tapir/RemoteBOY/README.md

Mechanical Files: https://cad.onshape.com/documents/e0ada551acd8132e7ef75c1d/w/a94723651199e5762ecd29c6/e/211c17ef0ce3b004e12369c1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
