tapir/RemoteBOY/KiCAD/Keystone_1020/1020.step

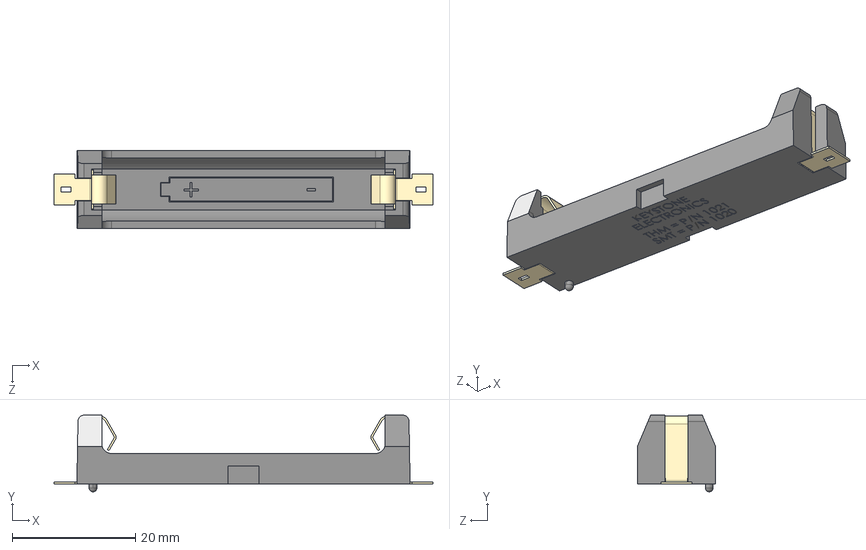
[picture p1: CAD file, 2024-03-24]
KiCAD/Keystone_1020/1020.step
61.5 x 12.4 x 12.7 mm
