tapir/RemoteBOY/KiCAD/remoteboy.kicad_pcb

## KiCad design KiCAD/remoteboy.kicad_pcb (2024-04-02)

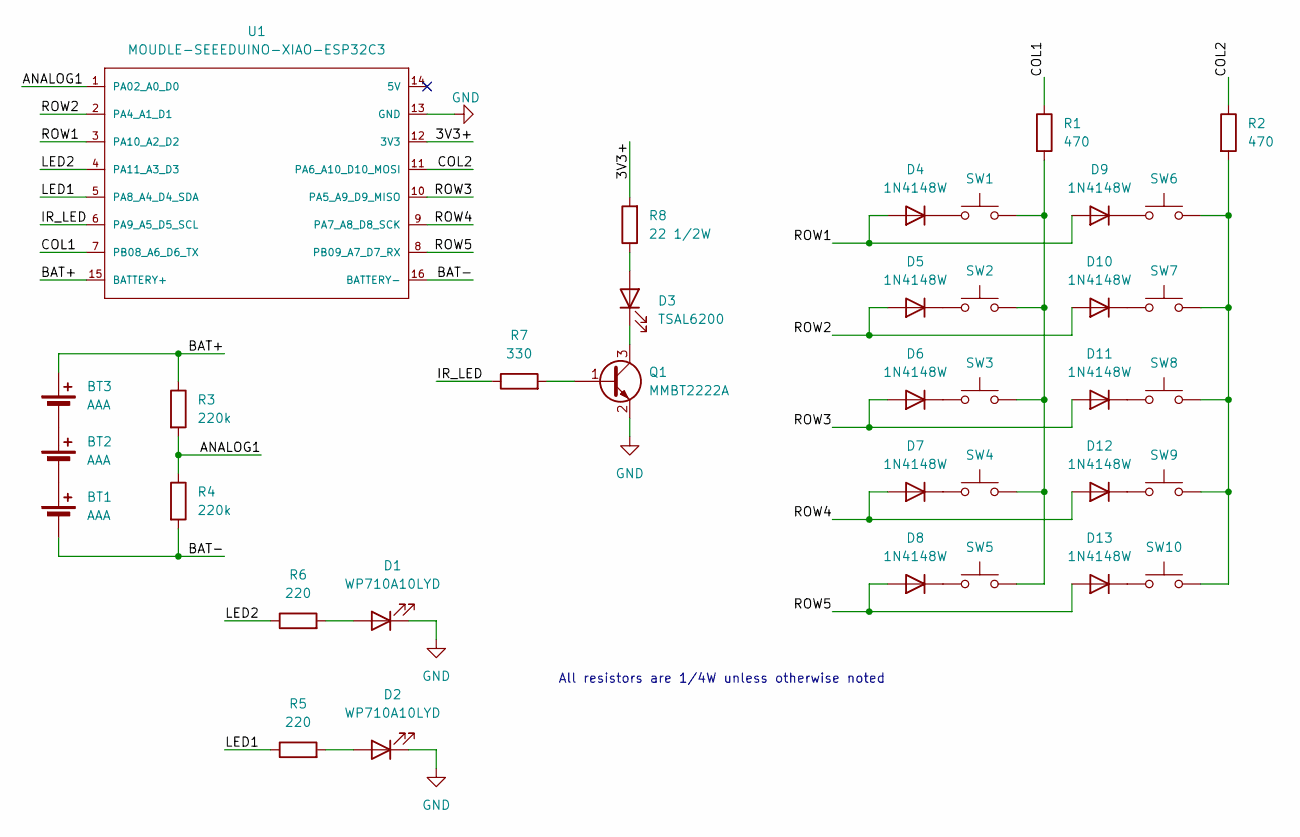
[picture p3: schematic remoteboy.kicad_sch]

Parts:
BT1, BT2, BT3: AAA; BAT_1020
D1, D2: WP710A10LYD; LED_D3.0mm
D3: TSAL6200; LED_D5.0mm
D4, D5, D6, D7, D8, D9, D10, D11, D12, D13: 1N4148W; D_SOD-123
Q1: MMBT2222A; SOT-23
R1, R2: 470; R_0805_2012Metric
R3, R4: 220k; R_0805_2012Metric
R5, R6: 220; R_0805_2012Metric
R7: 330; R_0805_2012Metric
R8: 22 1/2W; R_0805_2012Metric
SW1, SW2, SW3, SW4, SW5, SW6, SW7, SW8, SW9, SW10: SW_Push; SiliconeDome
U1: MOUDLE-SEEEDUINO-XIAO-ESP32C3; MOUDLE14P-SMD-2.54-21X17.8MM

Connections:
/3V3+: R8.2, U1.12 (3V3)
/ANALOG1: R3.2, R4.1, U1.1 (PA02_A0_D0)
/BAT+: BT3.1 (+), R3.1, U1.15 (BATTERY+)
/BAT-: BT1.2 (-), R4.2, U1.16 (BATTERY-)
/COL1: R1.1, U1.7 (PB08_A6_D6_TX)
/COL2: R2.1, U1.11 (PA6_A10_D10_MOSI)
/IR_LED: R7.1, U1.6 (PA9_A5_D5_SCL)
/LED1: R5.1, U1.5 (PA8_A4_D4_SDA)
/LED2: R6.1, U1.4 (PA11_A3_D3)
/ROW1: D4.2 (A), D9.2 (A), U1.3 (PA10_A2_D2)
/ROW2: D5.2 (A), D10.2 (A), U1.2 (PA4_A1_D1)
/ROW3: D6.2 (A), D11.2 (A), U1.10 (PA5_A9_D9_MISO)
/ROW4: D7.2 (A), D12.2 (A), U1.9 (PA7_A8_D8_SCK)
/ROW5: D8.2 (A), D13.2 (A), U1.8 (PB09_A7_D7_RX)
GND: D1.1 (K), D2.1 (K), Q1.2 (E), U1.13 (GND)
unnamed: BT1.1 (+), BT2.2 (-)
unnamed: BT2.1 (+), BT3.2 (-)
unnamed: D1.2 (A), R6.2
unnamed: D2.2 (A), R5.2
unnamed: D3.2 (A), R8.1
unnamed: D3.1 (K), Q1.3 (C)
unnamed: D4.1 (K), SW1.1
unnamed: D5.1 (K), SW2.1
unnamed: D6.1 (K), SW3.1
unnamed: D7.1 (K), SW4.1
unnamed: D8.1 (K), SW5.1
unnamed: D9.1 (K), SW6.1
unnamed: D10.1 (K), SW7.1
unnamed: D11.1 (K), SW8.1
unnamed: D12.1 (K), SW9.1
unnamed: D13.1 (K), SW10.1
unnamed: Q1.1 (B), R7.2
unnamed: R1.2, SW1.2, SW2.2, SW3.2, SW4.2, SW5.2
unnamed: R2.2, SW6.2, SW7.2, SW8.2, SW9.2, SW10.2

Notes on the sheet:
All resistors are 1/4W unless otherwise noted

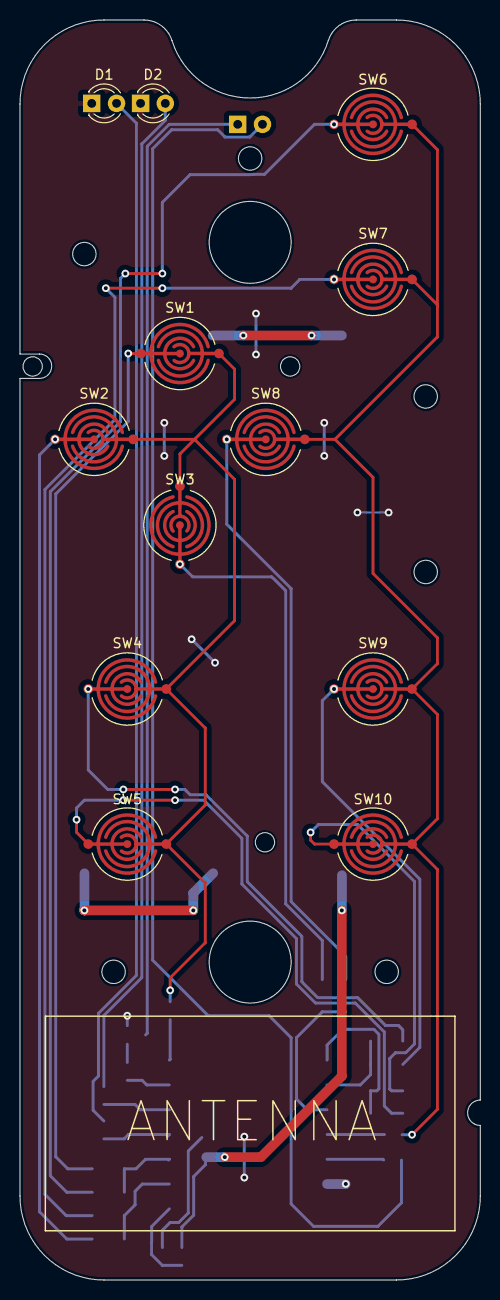
[picture p4: board remoteboy.kicad_pcb from above]

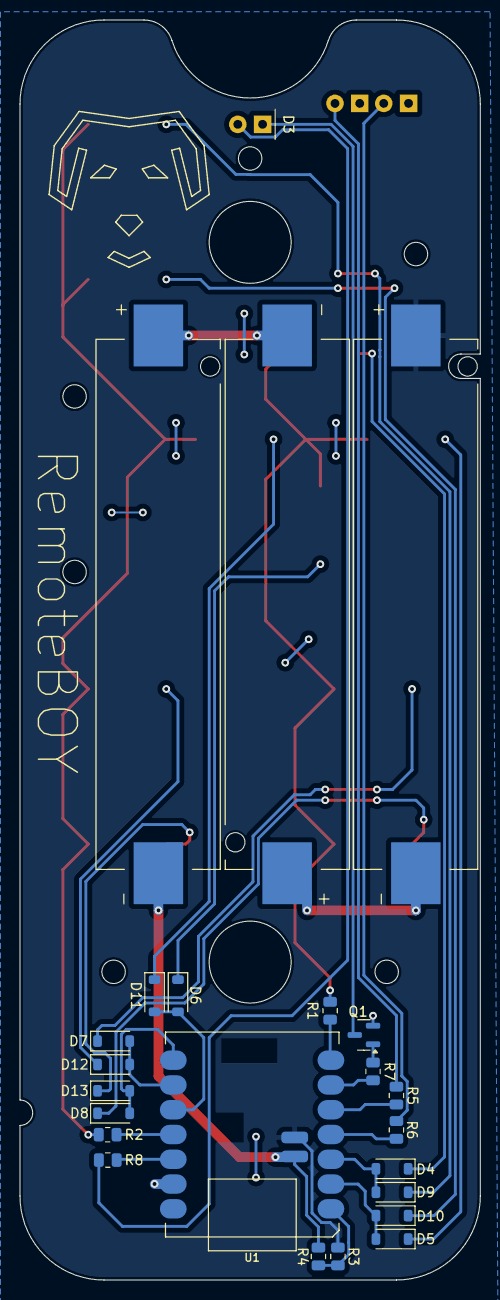
[picture p5: board remoteboy.kicad_pcb from below]

Board: 2 copper layers, 47.2 x 129.2 mm, 36 parts (24 on the bottom side), 34 nets.
