tapir/RemoteBOY/(commit log)

2024-03-24 KiCAD files
    [1020.step, Seeed Studio XIAO-ESP32-C3.step, remoteboy.kicad_pcb, remoteboy.kicad_sch]
2024-03-24 Arduino folder structure
2024-03-24 Fix board thickness
    [remoteboy.kicad_pcb]
2024-03-24 Fix antenna silkscreen size
    [remoteboy.kicad_pcb]
2024-03-24 Initial pin setup
2024-03-30 Clean a track
    [remoteboy.kicad_pcb]
2024-03-30 Implement LEDs
2024-03-31 Remove kicad prl
2024-03-31 Carry battery level logic inside BLE class
2024-03-31 Initial layer and button logic
2024-03-31 Complete all LED states
2024-04-01 Fix IR code size
    [IRRemote.cpp, IRRemote.h]
2024-04-01 IR implementation with non blocking repeat (#1)
    * IR implementation with non blocking repeat
    * Remove unused var
    * Coımments
    * Comments
    * Run IR repeat
    * Fix repeat check
    * Layout
    * Typedef name
    * Fix bluetooth pairing mode
    * Move const
    * Update gitignore
    [IRRemote.cpp, IRRemote.h, LED.cpp, LED.h, RemoteBOY.ino]
2024-04-02 LED fixes
2024-04-02 Fix battery
2024-04-02 Revert back frequency battery
    [Battery.cpp]
2024-04-02 Fix schematic and pcb
    [remoteboy.kicad_pcb, remoteboy.kicad_sch]
2024-04-03 Battery correction factor
2024-04-03 Button handling changes
2024-04-04 Remove IR, fix buttons, fix LEDs
    [Button.cpp, Button.h, IRRemote.cpp, IRRemote.h, LED.cpp, LED.h, RemoteBOY.ino]
2024-04-04 Remove select from special buttons
2024-04-05 Add menu button
2024-04-05 Power management
2024-04-07 Fix namings and organization
    [RemoteBOY.ino]
2024-04-07 Switch to edge trigger debounce
2024-04-07 Overhaul for wkaup button catch
2024-04-16 Power management done. 0.3mA on sleep.
